ntb-ch/db11/PartListDriveBoard.xlsx

Bill Of Materials PATHOS DriveBoard
 | Farnell (www.farnell.ch)
 | Quantity | Designator | Order Number | Description | minimum order quantity | Price | Remarks |  |  | price @50 pcs | 50
 | 14 | C2, C5, C9, C10, C13, C14, C16, C18, C19, C20, C23, C24, C25, C26 | 1301804 | Capacitor 100nF, 50V, 0603 | min. 10Stk. | 0.111 |  |  |  | 0.0192 | 13.44
 | 8 | C7, C8, C11, C12, C15, C17, C21, C22 | 3019524 | Capacitor 560pF, 50V, 0603 | min. 10Stk. | 0.0518 |  |  |  | 0.031 | 12.4
 | 8 | R1, R2, R3, R4, R5, R6, R7, R8 | 9330496 | Resistor 120Ohm 0603 | min. 10Stk. | 0.014 |  |  |  | 0.0117 | 4.68
 | 2 |  | 3003589 | Buchse ribboncable, 14Pol 2.54mm |  | 0.946 | ab 10Stk. 0.85 | use this to connect ControllerBoard with ribbon cable to DriveBoard |  | 0.734 | 73.4
 | 2 |  | 3003619 | Buchse ribboncable, 26Pol 2.54mm |  | 2.8 | ab 10Stk. 2.25 | use this to connect ControllerBoard with ribbon cable to DriveBoard |  | 4.6 | 460
 | 1 | P2 | 9838252 | Wire-To-Board Header 14Pol Baureihe 2500, 2.54mm |  | 1.86 | ab 10Stk. 1.66 |  |  | 1.51 | 75.5
 | 1 | P1 | 9838287 | Wire-To-Board Header 26Pol Baureihe 2500, 2.54mm |  | 1.87 | ab 10Stk. 1.71 |  |  | 1.54 | 77
 | 2 | C3, C6 | 1650831 | Capacitor 10nF, 50V, 0603 | min. 10Stk. | 0.0294 |  |  |  | 0.0234 | 2.34
 | 4 | U1_Drive1, U1_Drive2, U1_Drive3, U1_Drive4 | 1593465 | Board-to-Board Header, 12 Pin, 2.54mm, 1 Row | min. 10Stk. | 0.208 |  | need 11Pins, remove 1 Pin before Assembly |  | 0.167 | 33.4
 | 4 | U1_Drive1, U1_Drive2, U1_Drive3, U1_Drive4 | 1668305 | Board-to-Board Header, 18 Pin, 2.54mm, 2 Rows |  | 4.45 | ab 10 Stk. 3.65 |  |  | 3.1 | 620
 | Mouser (www.mouser.ch)
 | Quantity | Designator | Order Number | Description | minimum order quantity | Price | Remarks
 | 5 | U3, U4, U6, U7, U8 | 595-SN74LVC2T45DCTR | SN74LVC2T45DCTR Level-Shifter | ab 10Stk. | 0.544 |  |  |  | 0.351 | 87.75
 | 2 | U1_Drive1, U1_Drive2, U1_Drive3, U1_Drive4 | 595-AM26LV32CDR | AM26LV32CDR RS-422 Interface Quad Line Receiver |  | 1.36 | ab 10Stk. 1.09 |  |  | 0.838 | 83.8
 | 4 | P3_Drive1, P3_Drive2, P3_Drive3, P3_Drive4 | 710-61201021621 | Würth Header 10 Pol 61201021621 Male |  | 0.431 | ab 10 Stk. 0.42 |  |  | 0.347 | 69.4
 | 2 | C1, C4 | 810-C4532X5R0J107M | Capacitor 100uF, 6.3V, 1812 |  | 2.12 | ab 10Stk. 1.77 |  |  | 1.22 | 122
 | 1 | P6 | 651-1711725 | Phoenix Contact Anschlussblock 5.08 Raster |  | 1.66 | ab 10Stk. 1.60 |  |  | 1.56 | 78
 | 1 | C27 | 598-SLP103M035C7P3 | Capacitor Alu-Electrolytic 10mF, 35V |  | 3.46 | ab 10Stk. 2.79 |  |  | 2.49 | 124.5
 | 4 | P5_Drive1, P5_Drive2, P5_Drive3, P5_Drive4 | 651-1984633 | Phoenix Header 4 Position, 3.5mm |  | 0.78 | ab 10Stk. 0.75 |  |  | 0.698 | 139.6
 | 4 | P4_Drive1, P4_Drive2, P4_Drive3, P4_Drive4 | 651-1984646 | Phoenix Header 5 Position, 3.5mm |  | 0.917 | ab 10Stk. 0.879 |  |  | 0.735 | 147
 | 1 | D1 | 512-SMBJ54A | SMBJ54A TVS Diode 600W, 60 to 66.3V |  | 0.561 | ab 10 Stk. 0.317 |  |  | 0.317 | 15.85
 | 1 | F1 | 576-0456040.DR | Fuse 40A, Fast Blow, Littelfuse |  | 4.88 | ab 10Stk. 4.56 |  |  | 3.54 | 177
 | 1 | R9 | 660-RN73H1JT2201F100 | Resistor 2.2kOhm, 0603 |  | 0.293 | ab 50 Stk. 0.278 |  |  | 0.278 | 13.9
 |  |  |  |  |  |  |  |  | Total 50 pcs: |  | 2430.96
 | Taken from Stock: |  |  |  |  |  |  |  | price per piece: |  | 48.6192
 | 1 |  |  | Ribbon Cable AWG28, min. 26 Pins |  |  | used to connect DriveBoard to ControllerBoard
 | Toradex
 | Lager
