ntb-ch/db11/DriveBoard.pdf

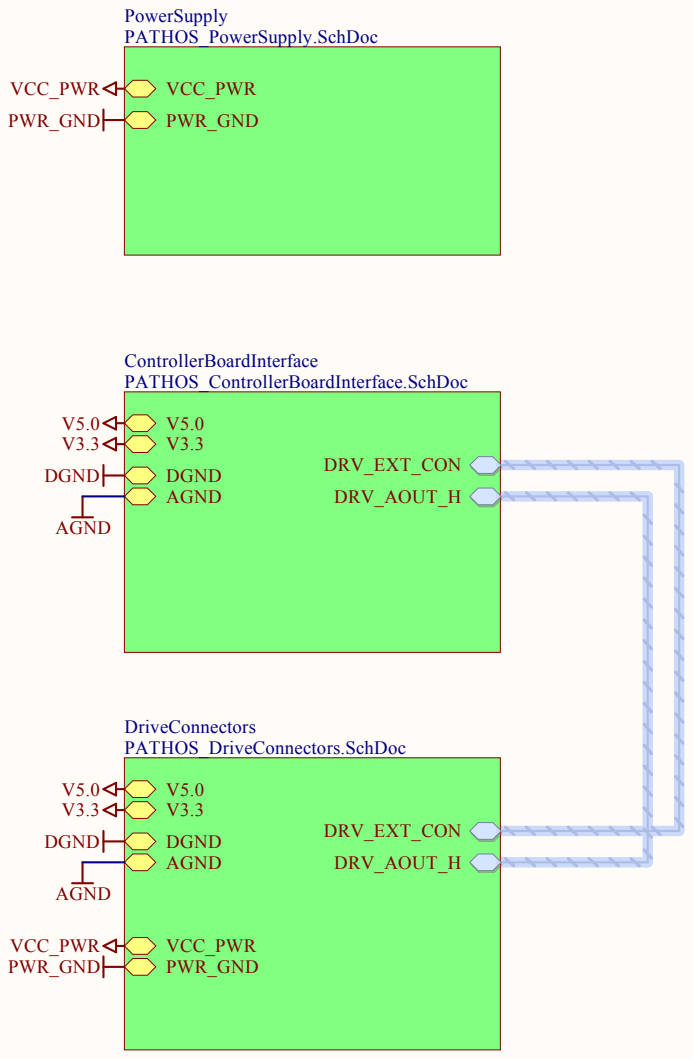
[picture p1: page 1]

Drive Board for PATHOS

Main Sheet for Drive Board

Name: A. Kalberer | Checked: *

NTB Interstate University of Applied
Sciences of Technology Buchs
Werdenbergstrasse 4

Size: A4 | Number: 1 | Revision: 0.1

Date:
D:\work\PATHOS\SVN\03_Artworks\Panels\Electronics\DriveBoard\AltiumFiles\PATHOS_DriveBoard.SchDoc

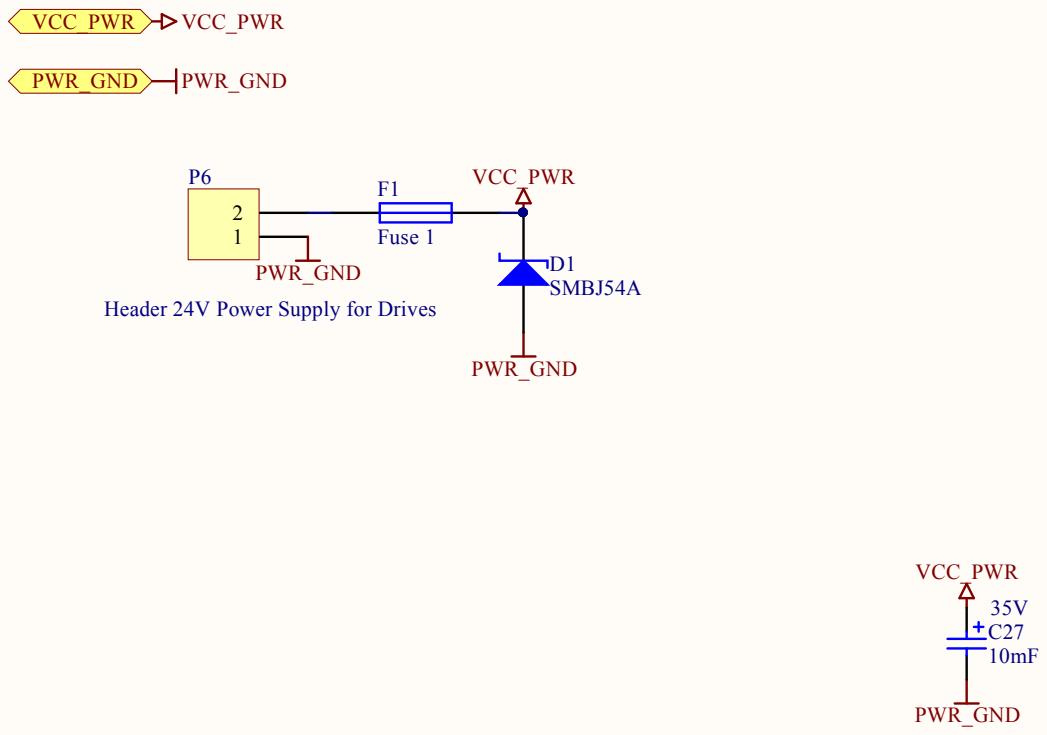
[picture p2: page 2]

Header 24V Power Supply for Drives

Motor/Drive Power Supply

Name: A. Kalberer | Checked: *

NTB Interstate University of Applied
Sciences of Technology Buchs
Werdenbergstrasse 4

Size: A4 | Number: 2 | Revision: 0.1

D:\work\PATHOS\SVN\03_Artworks\Panels\Electronics\DriveBoard\AltiumFiles\PATHOS_PowerSupply.SchDoc

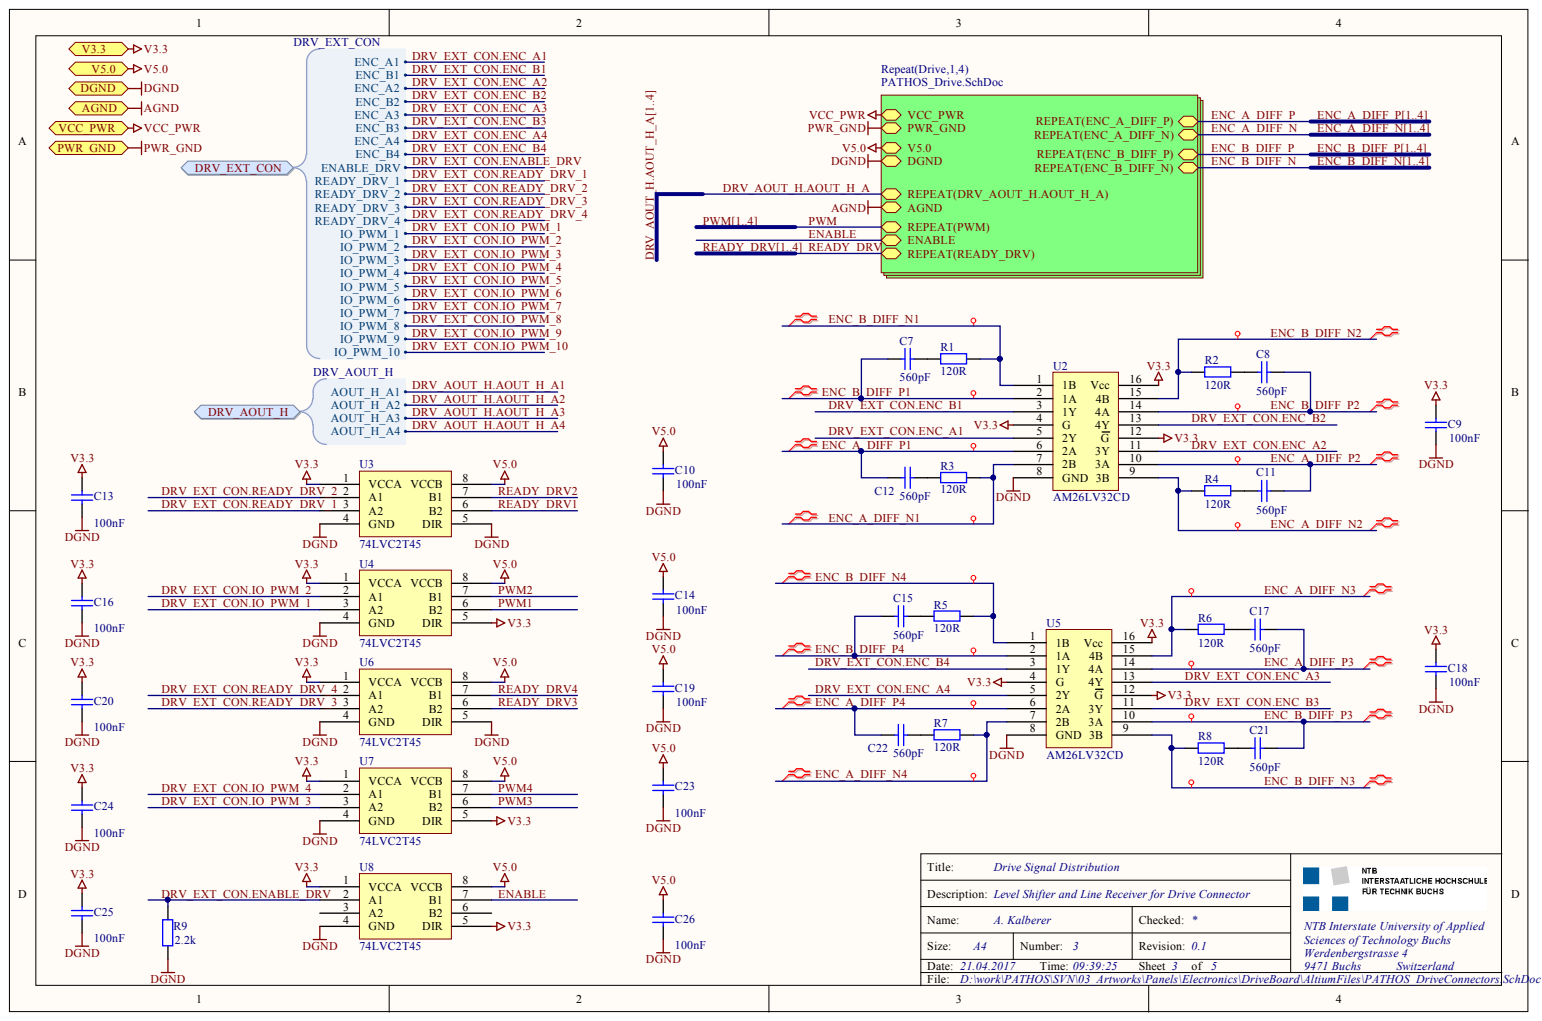
[picture p3: page 3]

Name: A. Ka l berer | Checked : *

Size: A 4 | N umber: 3 | Rev i s i o n : 0.1

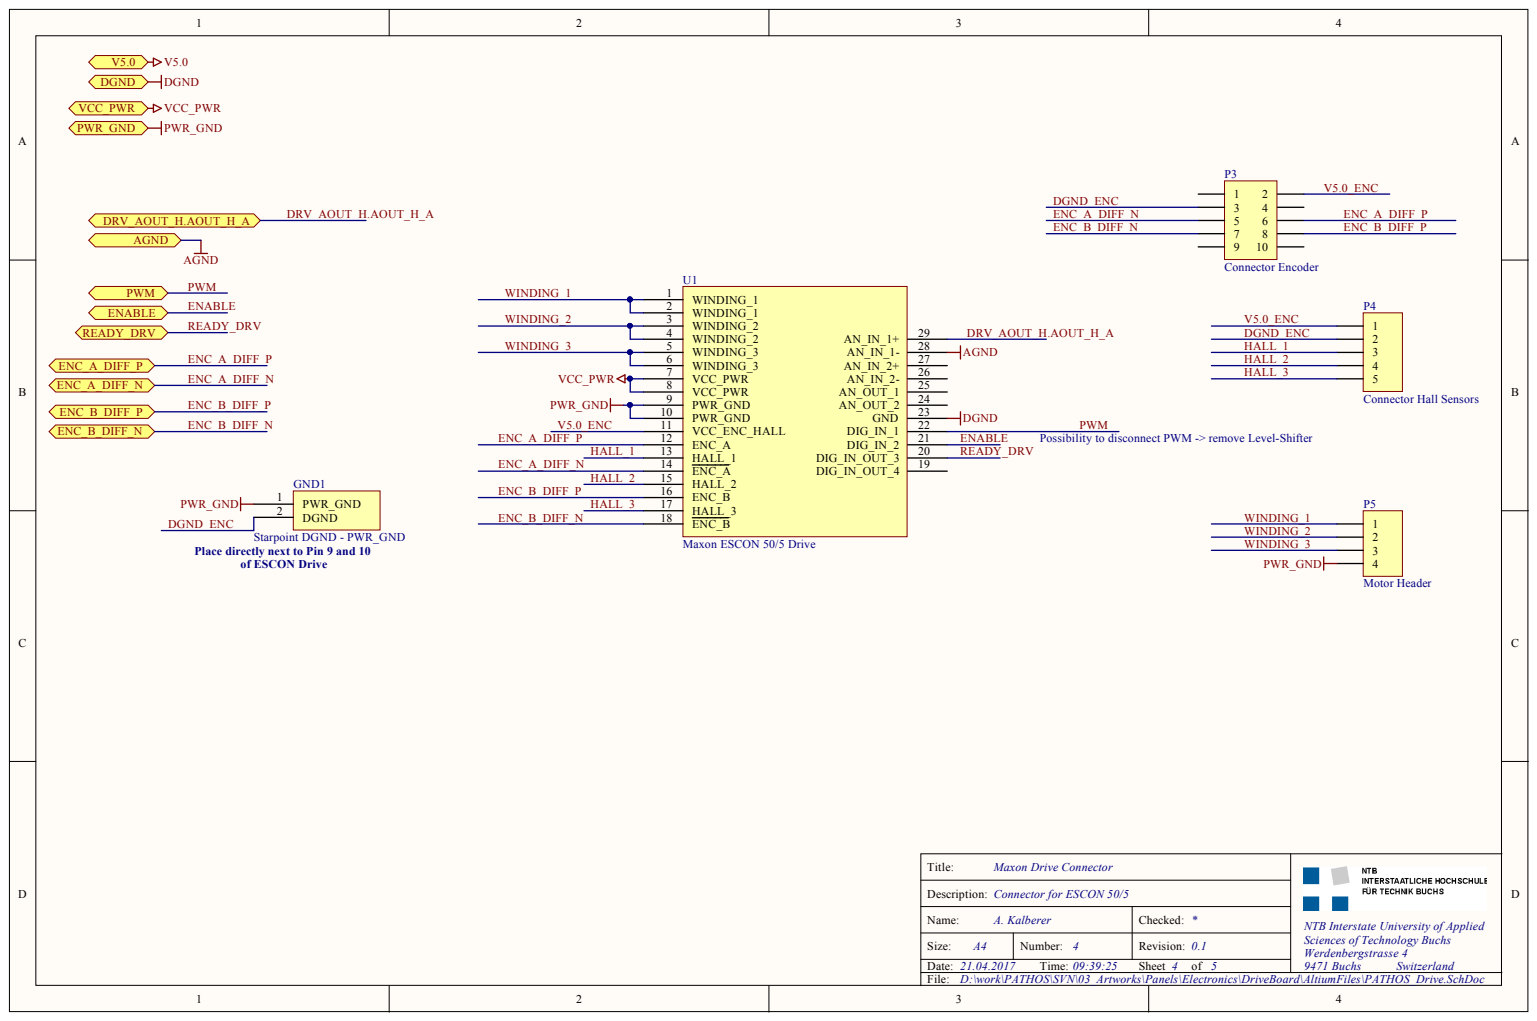
[picture p4: page 4]

Name: A. Ka l berer | Checked : *

Size: A 4 | N umber: 4 | Rev i s i o n : 0.1

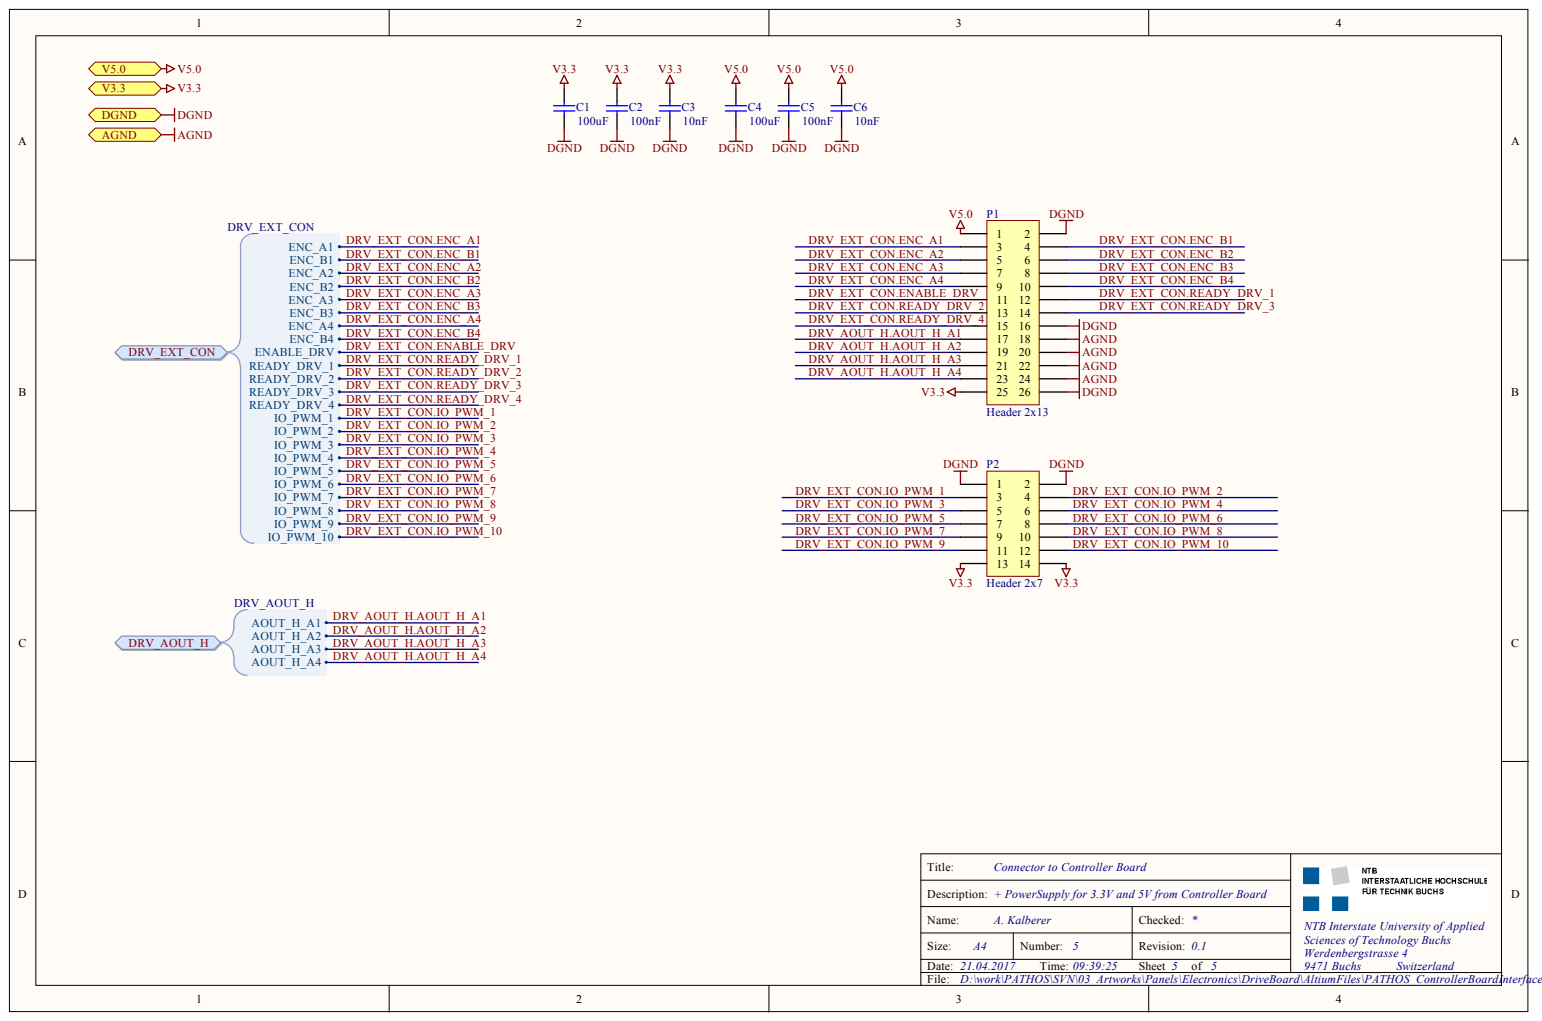
[picture p5: page 5]

Name: A. Ka l berer | Checked : *

Size: A 4 | N umber: 5 | Rev i s i o n : 0.1

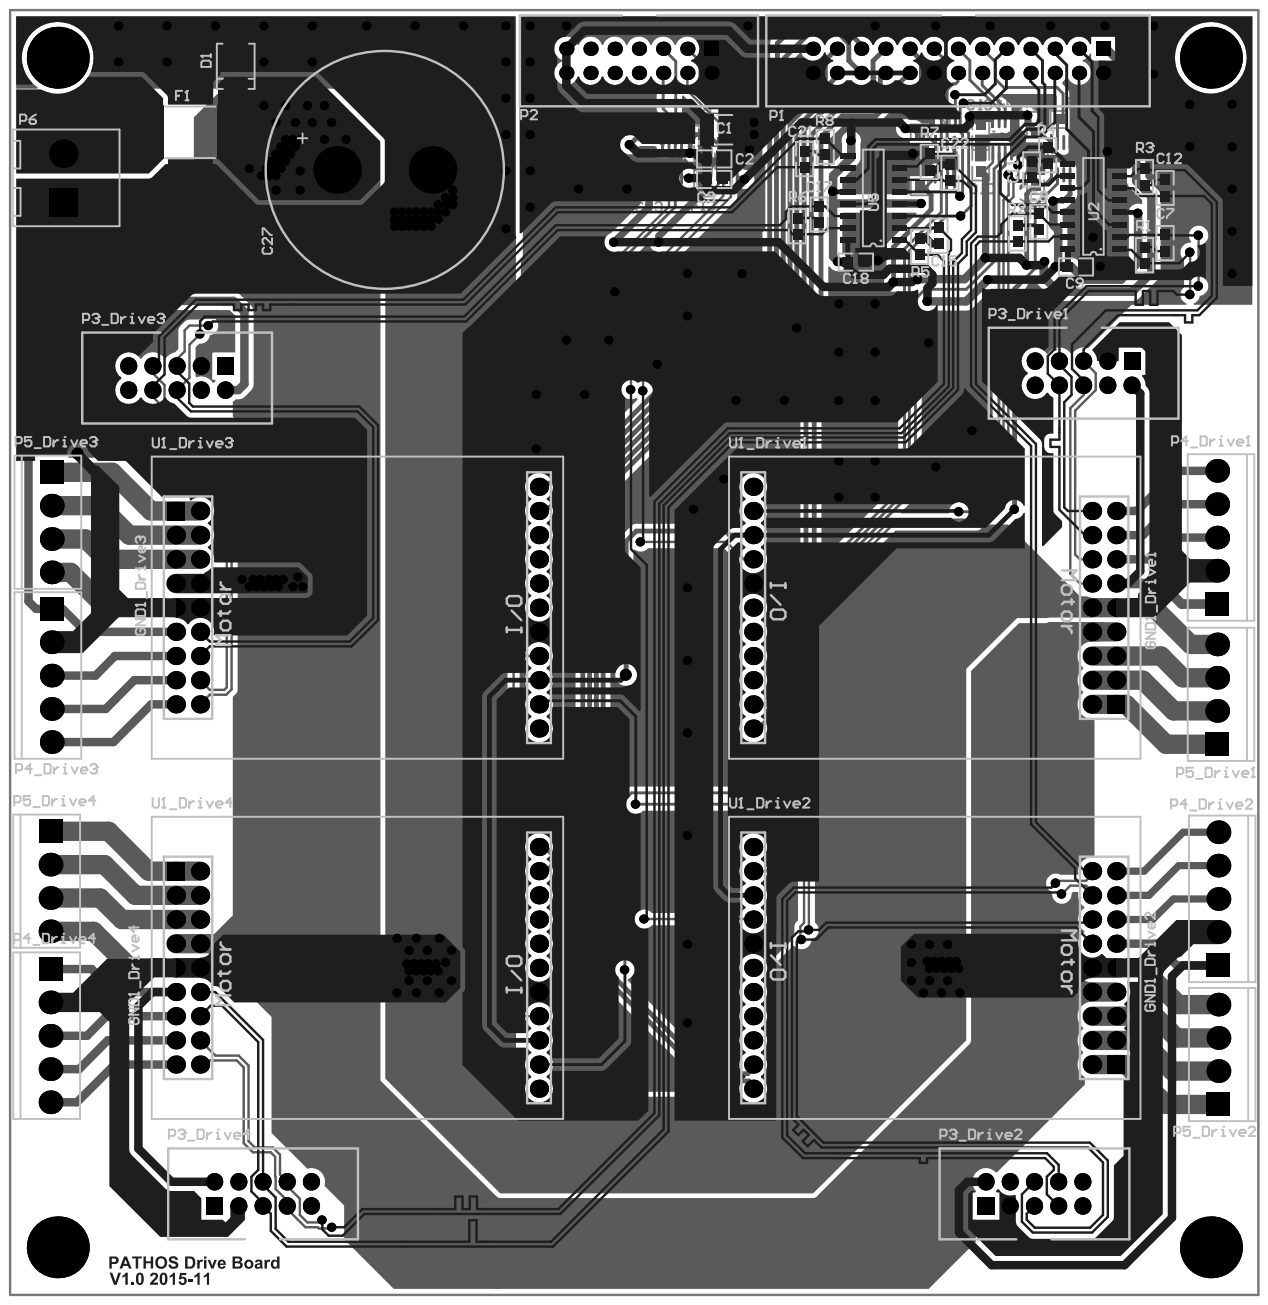
[picture p6: page 6]
