ntb-ch/db11/(list of files, drawings)

Other design files:
AltiumFiles/DriveBoard.PrjPcb
AltiumFiles/PATHOS_ControllerBoardInterface.SchDoc
AltiumFiles/PATHOS_Drive.SchDoc
AltiumFiles/PATHOS_DriveBoard.PcbDoc
AltiumFiles/PATHOS_DriveBoard.SchDoc
AltiumFiles/PATHOS_DriveConnectors.SchDoc
AltiumFiles/PATHOS_PowerSupply.SchDoc
